sanvinpaul/adas-ecu-edgeai-sensor-fusion/can-intrusion-detection/README.md

# CAN Intrusion Detection (WiFi infotainment attack surface + autoencoder IDS)

Adds an AI-based intrusion-detection layer and a realistic attack surface. The infotainment head unit
hosts a WiFi access point; an attacker who reaches it injects spoofed CAN frames,
and a separate gateway ECU running an **autoencoder** detects the anomaly and warns
the driver. This mirrors the 2015 Jeep Cherokee attack path (infotainment → CAN).

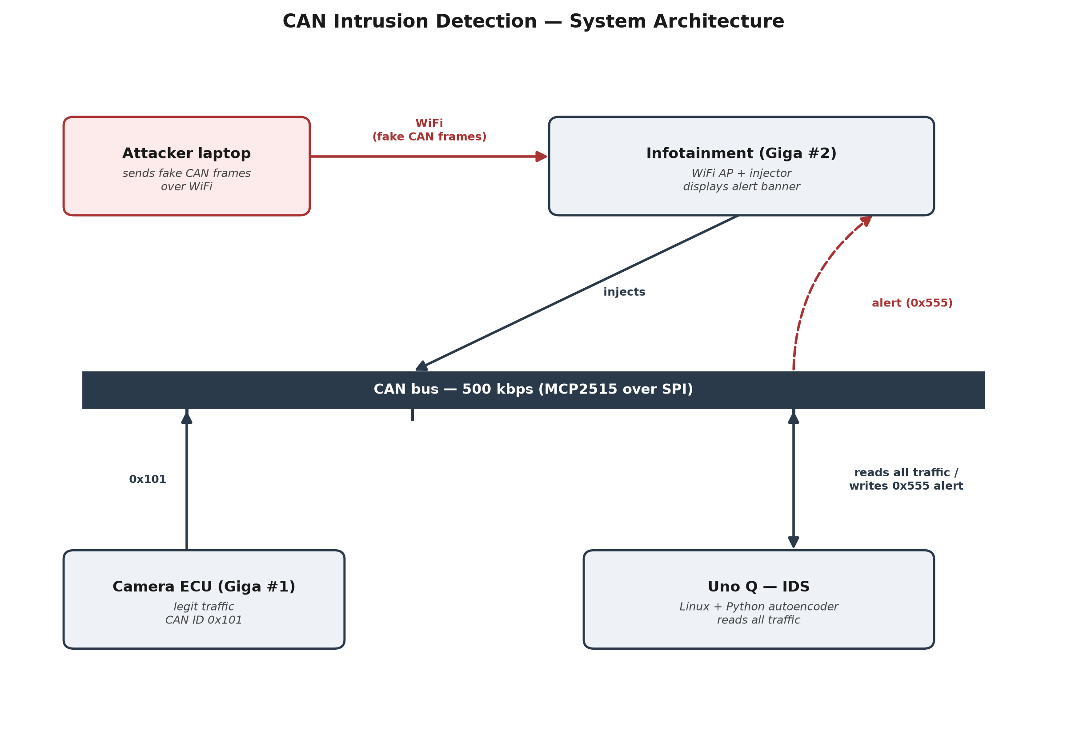
[picture p1: docs/architecture-can-intrusion-detection.png]
architecture


> Export the architecture diagram to `docs/architecture-can-intrusion-detection.png`.

## Nodes

| Node | Firmware / code | Role |
|---|---|---|
| Camera ECU (Giga #1) | `firmware/giga1_camera_ecu/` | Unchanged from the Sensor Fusion Baseline feature — legit `0x101` baseline traffic |
| Infotainment (Giga #2) | `firmware/giga2_infotainment/` | WiFi AP + web dashboard; injects `spoof/flood/replay/fuzz`; shows the alert |
| WiFi AP checkpoint | `firmware/phase1_wifi_ap_test/` | Standalone test to prove the AP before integration |
| IDS gateway (Uno Q) | `firmware/unoq_can_forwarder/` + `ids/` | MCU streams frames to Linux; Python autoencoder scores them and broadcasts `0x555` |

## Why an autoencoder

Real attacks are open-ended and unlabeled. The autoencoder trains only on *normal*
traffic and flags anything that reconstructs poorly — so it generalises to attacks
it never saw. Detection leans on timing/frequency features (a spoofed `0x101`
doubles its rate and breaks its regular period).

## Host-side pipeline (`ids/`)

| Script | Purpose |
|---|---|
| `features.py` | Shared window feature extraction (identical in train + detect) |
| `capture.py` | Log CAN frames to labeled CSV |
| `train.py` | Train the autoencoder on normal data, pick a threshold |
| `detect.py` | Live inference; sends `ALERT,type,score` to the MCU on anomaly |

## Run it

```bash
# 1) flash all four firmware sketches (start with phase1_wifi_ap_test on Giga #2)
# 2) capture data on the Uno Q Linux side
cd ids && pip install -r requirements.txt
python capture.py --port /dev/ttyACM0 --label normal --out ../data/normal.csv
python capture.py --port /dev/ttyACM0 --label spoof  --out ../data/attack_spoof.csv
# 3) train
python train.py --normal ../data/normal.csv --attacks ../data/attack_spoof.csv
# 4) detect live
python detect.py --port /dev/ttyACM0
```

Connect a laptop to the `CarInfotainment` AP, trigger an injection from the
dashboard, and watch the alert reach the head unit's OLED and web page.

## Results

### v1 -- Initial training run

First real hardware capture: ~16 minutes of normal traffic (78 training
windows, WINDOW_SIZE=50 frames), plus one capture per attack type triggered
by clicking each dashboard injection link 5-10 times during a ~1 minute
window.

Threshold (99.5th pct of normal error): 1.46265

| Attack | Detection rate | Windows evaluated |
|---|---|---|
| Spoof  | 40.0% | 35 |
| Flood  | 100.0% | 7  |
| Replay | 100.0% | 8  |
| Fuzz | 100.0% | 8  |

**Flood, replay, and fuzz were detected perfectly.** Each produces a large,
unambiguous statistical shift -- a 200-frame burst, a duplicated timing
pattern, or entirely foreign CAN IDs -- all of which stand out sharply against
the learned "normal" baseline.

**Spoof detection was weak (40%), and that's the attack that matters most**
for this project's threat model -- it's the one modeled directly on the real
Jeep Cherokee case study (https://www.wired.com/2015/07/hackers-remotely-kill-jeep-highway/)
that motivates the whole design (an attacker impersonating a legitimate ECU).
The likely cause: injectSpoof() sends exactly **one** extra 0x101 frame
per click, versus 200 frames per flood click or continuous foreign traffic
for fuzz. With only 5-10 clicks spread across a full minute of otherwise
normal traffic, the perturbation to the 0x101 timing/frequency features was
genuinely subtle -- arguably realistic for how a careful real-world attacker
would behave, but hard for a model trained on only ~78 normal windows to
separate confidently from natural jitter.

This is a legitimate, documented finding in CAN IDS research more broadly:
volume-based attacks (flooding, fuzzing) are inherently easier to detect via
timing/frequency features than stealthy identity-spoofing attacks that mimic
legitimate traffic patterns closely.

**Next step:** recapture spoof traffic with much more aggressive injection
(rapid repeated clicks rather than spread out) to give the model a stronger
signal, then retrain. Results below once that's complete.

### v2 -- Investigating the spoof detection gap

The obvious first move -- recapture spoof traffic with much more aggressive
injection (rapid clicking instead of spread out) -- didn't move the needle:

```
Threshold (99.5th pct of normal error): 1.22123
  attack_spoof.csv:  38.6% (44 windows)   [v1 was 40.0%, 35 windows]
  attack_flood.csv:  100.0% (7 windows)
  attack_replay.csv: 100.0% (8 windows)
  attack_fuzz.csv:   100.0% (8 windows)
```

Despite capturing far more total traffic (2222 frames vs. ~1750 in v1), the
spoof detection rate was flat. **That result rejected the v1 hypothesis** --
signal volume wasn't the problem.

**Root cause, found by inspecting the capture directly:** capture.py labels
an entire file "spoof", but injectSpoof() only fires on a dashboard click --
the camera ECU keeps transmitting its own legitimate 0x101 the whole
capture regardless. Checking attack_spoof.csv directly (d1==255 is
injectSpoof()'s signature payload byte): only **99 of 1140** 0x101 frames
(8.7%) were actually injected. Nearly all of the file's 44 windows almost
certainly contained **zero** injected frames -- meaning the "detection rate"
metric was largely measuring the model's behavior on windows that were
mislabeled attacks but were actually just normal traffic.

A diagnostic script (ids/diagnose_spoof_labels.py) was added to recompute
ground truth per window (does this specific window contain a frame matching
the injection signature?) instead of trusting the file-level label:

```
Total windows: 44
  Windows with >=1 injected frame (true attack): 7
  Windows with 0 injected frames (mislabeled "spoof", actually normal): 37

Corrected detection rate (recall on TRUE attack windows only): 7/7 = 100.0%
False alarm rate on windows mislabeled "spoof" but actually clean: 10/37 = 27.0%
```

**The model detects spoofing perfectly (7/7) once ground truth is measured
correctly at the window level.** The original 38-40% figures were an
artifact of file-level labeling granularity, not a model weakness.

The 27% false-alarm rate on the mislabeled-clean windows was checked
separately against the true baseline capture, to rule out general threshold
miscalibration:

```
Normal windows: 78, flagged as anomaly: 2 (2.6%)
```

2.6% is close to the nominal ~0.5% expected from a threshold set at the
99.5th percentile of a small (~15-window) validation split -- reasonable given
the dataset size. The 27% figure, roughly 10x higher, is specific to
conditions *during the spoof-testing session itself* (active clicking,
WiFi/HTTP load from the dashboard requests, possible movement near the
ultrasonic sensor) rather than a broken threshold -- the model stays quiet on
genuinely calm traffic but is more sensitive to session-level environmental
drift than pure attack presence.

| Metric | v1 (naive, file-level label) | v2 (corrected, per-window ground truth) |
|---|---|---|
| Spoof detection | 40.0% | **100.0%** (7/7 true-attack windows) |
| False alarms on "clean" windows | n/a | 27.0% (10/37, session-specific) |
| False alarms on true baseline | n/a | 2.6% (2/78, near-nominal) |

### Key takeaway

The real lesson from this project wasn't "tune the model until spoof detection
improves" -- it was that **the evaluation methodology itself had a labeling
granularity mismatch** between file-level attack labels and per-window ground
truth. That's arguably a more valuable finding than a clean 100% number would
have been on its own.

### v3 -- Firmware fix + fresh baseline (root cause resolved)

Live detection (`detect.py`) surfaced a third issue not visible in offline
training/evaluation at all: near-continuous low-grade false alarms whenever a
WiFi client was connected to the dashboard, and silence when it wasn't. Two
causes were found and fixed in sequence:

1. **32-bit `micros()` rollover** -- after an extended `detect.py` session,
   Arduino's 32-bit microsecond counter wrapped, and sorting timestamps by
   raw value (the original implementation) broke across that boundary,
   producing single gaps of ~4.29 million ms and reconstruction errors in the
   tens of thousands. Fixed in `features.py` by unwrapping timestamps in
   natural arrival order instead of sorting by value.
2. **WiFi-serving jitter** -- the dashboard's auto-refresh (originally every
   2s) triggered `handleClient()`, which made ~15 separate blocking network
   writes to build the HTML response. That blocking time delayed the next
   scheduled `0x102` CAN send, disrupting timing the model had only ever seen
   as precise. This was a genuine train/serve mismatch: `normal.csv` had been
   captured with the dashboard idle, not reflecting real operating conditions
   (the dashboard has to be open to test attacks).

The second issue was deliberately fixed at the **firmware level** rather than
by retraining the model to tolerate the jitter. The disrupted features
(`iat_mean`/`iat_std` for `0x101` and `0x102`) are the exact features
spoof/replay attacks manifest through -- broadening "normal" to include
timing jitter risked desensitizing the model to the real attacks this
feature exists to catch. `sendDashboard()` was consolidated into a single
buffered write and the refresh interval lengthened to 5s, both reducing how
much and how often serving disrupts CAN timing.

A fresh `normal.csv` was then captured **with the dashboard open** (matching
real operating conditions) and the ultrasonic sensor allowed to vary
naturally, rather than sitting artificially static -- a model trained on zero
payload variation would flag legitimate real-world movement as anomalous.

```
Threshold (99.5th pct of normal error): 22.57849   [v2 was 1.22123]
  attack_spoof.csv:  15.9% (44 windows)   [naive, file-level label]
  attack_flood.csv:  100.0% (7 windows)
  attack_replay.csv: 100.0% (8 windows)
  attack_fuzz.csv:   100.0% (8 windows)
```

Corrected per-window ground truth (diagnose_spoof_labels.py) against the new
model:

```
Corrected detection rate (recall on TRUE attack windows only): 7/7 = 100.0%
False alarm rate on windows mislabeled "spoof" but actually clean: 0/37 = 0.0%
```

| Metric | v2 | v3 |
|---|----|----|
| Threshold | 1.22 | 22.58 |
| Spoof detection (true-attack windows) | 100.0% (7/7) | **100.0% (7/7)** |
| False alarms on mislabeled-clean windows | 27.0% (10/37) | **0.0% (0/37)** |
| Flood / Replay / Fuzz | 100% | 100% |

**Fixing the root cause rather than retraining around it preserved full
attack sensitivity while eliminating false alarms from normal operation.**
Had the jitter simply been tolerated via retraining alone (without knowing
whether that traded away sensitivity), there would have been no way to
distinguish "the model got more robust" from "the model got less alert" --
the corrected per-window metric is what makes that distinction possible.

## On-device deployment

Two parallel efforts to run this model on real edge/automotive hardware,
rather than only a development laptop.

### Qualcomm AI Hub — NPU benchmarking (✅ complete, verified)

The trained autoencoder (`model.keras`) was converted to ONNX
(`convert_to_onnx.py`) — Qualcomm AI Hub's `submit_compile_job()` only
accepts PyTorch or ONNX models, not native Keras. The conversion was
numerically verified before use: the ONNX model's output matched the
original Keras model exactly (max absolute difference `0.0`) on a test
input.

The model was then compiled and profiled on a real, hosted **SA8775P ADP**
(Qualcomm Snapdragon Ride automotive SoC) via `submit_to_aihub.py`:

```
Device:            SA8775P ADP (Qualcomm® SA8775P), Android 14
Input:              float32[1, 10]
Status:             SUCCESS (compile + profile)
Inference time:     0.2 ms (minimum / median)
Peak memory:        0 - 18 MB
NPU placement:      4/4 layers (100%) -- "Model is fully delegated=true"
                     in the raw runtime log, zero CPU fallback
Compute cycles:     3,736 total across all 4 layers (~2 us of raw NPU math)
Delegate overhead:  ~413 us (QNN/HTP pipeline dispatch)
```

**Comparison to development hardware:** 0.2 ms on the SA8775P's NPU vs.
14.68 ms (median) on a laptop CPU — roughly a **73x** speedup on dedicated
automotive NPU silicon.

**Notable finding:** the actual NPU computation for this model is only ~2 us
(3,736 compute cycles); the ~413 us `TfLiteQnnDelegate` dispatch step
dominates total latency. For a model this small, NPU invocation overhead is
the real bottleneck, not compute -- meaning a meaningfully larger/more
complex model could likely run with a similar latency profile, since the
fixed dispatch cost, not FLOPs, is what's being paid here.

**Known discrepancy, documented rather than hidden:** the AI Hub dashboard
labels the target device "SA8775P ADP," but the raw runtime log's own
Android system properties self-report differently
(`ro.soc.model = SA8255P`, `Detected Qualcomm SOC=SA8255`). Both chips are
part of the same Snapdragon Ride/Cockpit family; this is very plausibly a
shared reference/development platform used across closely related silicon
variants, but that explanation isn't independently confirmed.

### App Lab Custom Brick — on-device Uno Q deployment (🚧 in progress)

Separately, the same detection logic (`ids_core.py`) was adapted into an
Arduino App Lab Custom Brick, intended to run the full IDS natively on the
Uno Q's own Linux side -- no laptop, no external serial tether -- using
`Bridge.call()`/`Bridge.provide()` RPC instead of raw serial parsing (see
`onboard-brick/`).

**Status so far:**
- Sketch compiles and flashes successfully (10% program storage, 12% dynamic
  memory used).
- The Brick's Docker container builds successfully (TensorFlow and all
  dependencies install cleanly).
- Both containers (`can_ids_scorer` and `main`) start.
- **Runtime errors occur during App Lab's "Run"** that haven't been
  root-caused yet -- the Brick does not yet reliably reach a confirmed
  working state end-to-end. Two known open uncertainties going in: whether
  `Bridge.call()`'s multi-argument form (used to push each CAN frame's ID,
  length, and 8 data bytes) is actually supported the way it's written, or
  needs packing into a single argument instead; and whether the shared
  modules' import path within the Brick's sandboxed environment is correct.

This is left as an open item rather than a completed feature -- unlike the
AI Hub results above, this has not yet been verified working on hardware.

### Roadmap

- Capture ground truth at the frame level (e.g. have the firmware stamp
  injected frames, rather than inferring via the d1==255 heuristic) so
  future evaluation doesn't need a separate diagnostic pass.
- Capture a larger normal baseline (current: 78 windows / ~16 minutes) to
  tighten threshold calibration.
- Compare against an Isolation Forest baseline.
