sanvinpaul/adas-ecu-edgeai-sensor-fusion/(commit log)

2026-07-13 feat(sensor-fusion-baseline): camera ECU sends brightness/visual-cue on 0x101
2026-07-13 feat(sensor-fusion-baseline): ultrasonic node broadcasts 0x102 and drives OLED
2026-07-13 feat(sensor-fusion-baseline): Uno Q aggregator prints JSON telemetry over serial
2026-07-13 docs(sensor-fusion-baseline): baseline sensor-network overview and run steps
2026-07-13 chore(can-intrusion-detection): carry over camera ECU as legit baseline traffic
2026-07-14 fix(sensor-fusion-baseline): slow Board2 ultrasonic broadcast to 500ms to relieve Board1 CAN buffer
    The 100ms transmit rate on Board2 was overloading the MCP2515's transmit
    buffer on Board1's side, causing errors. Slowing to 500ms brought bus
    traffic within comfortable limits and the errors disappeared completely.
    [giga2_sensor_display.ino]
2026-07-14 fix(can-intrusion-detection): drain unread CAN RX buffers on camera ECU
    The camera ECU only transmits but never read incoming CAN frames,
    letting the MCP2515's RX buffer fill up and trip CTRLERROR. Drain
    unread messages each loop and log the raw EFLG value on recovery for
    diagnosis.
    [giga1_camera_ecu.ino]
2026-07-14 fix(can-intrusion-detection): slow Board2 ultrasonic broadcast to 500ms to relieve Board1 CAN buffer
    Same MCP2515 TX buffer overload seen on the sensor-fusion baseline
    applies here too — 100ms was too fast for Board1 to keep up. Also
    leaves a commented-out SPI1.begin() as a note for a possible second
    SPI bus during future debugging.
    [giga2_infotainment.ino]
2026-07-14 chore(can-intrusion-detection): namespace WiFi AP test SSID to avoid collisions
    Renamed the phase1 test AP SSID to "CarInfotainment_san" to avoid
    colliding with other AP tests on the same network during bring-up.
    [phase1_wifi_ap_test.ino]
2026-07-14 fix(sensor-fusion-baseline): drain unread CAN RX buffers on camera ECU
    Same fix as can-intrusion-detection's camera ECU: this node only
    transmits but never read incoming CAN frames, letting the MCP2515's
    RX buffer fill up and trip CTRLERROR.
    [giga1_camera_ecu.ino]
2026-07-15 fix(can-intrusion-detection): drain all pending CAN frames per loop on infotainment node
    Same root cause as the earlier camera ECU fix, milder form: giga2_infotainment.ino
    used a single 'if (CAN.checkReceive()...)' instead of a loop, so only one message
    was drained from the MCP2515's receive buffers per loop() iteration. Since this
    node's loop is the busiest in the system (WiFi/HTTP handling, OLED refresh,
    ultrasonic), iteration rate can slow enough for incoming frames (0x101, and
    eventually 0x555) to queue up faster than they're drained, overflowing the
    2-deep hardware RX buffer and tripping CAN_CTRLERROR -- observed live during
    a 'normal' data capture run.
    Fix: changed the single if to a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
    [giga2_infotainment.ino]
2026-07-15 docs(can-intrusion-detection): document v1 training results and spoof detection gap
    First real hardware training run: autoencoder trained on 78 normal windows
    (~16 min capture), evaluated against all four attack types.
    Flood/replay/fuzz detected at 100%. Spoof detection came in at only 40% --
    notable because spoofing is the attack this project's threat model is built
    around (impersonating a legitimate ECU, per the Jeep Cherokee case study).
    Root-caused to injectSpoof() producing a much subtler signal (1 frame/click)
    than the other attacks (200 frames/click for flood, continuous foreign
    traffic for fuzz), combined with a fairly small normal-traffic training set.
    Documented as an honest v1 b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
2026-07-15 fix(can-intrusion-detection): skip malformed CAN frames instead of crashing capture.py
    Hit during aggressive spoof-attack recapture: rapid CAN traffic caused a
    serial line to arrive as valid JSON but missing the 'dlc' key (likely a
    dropped byte on the USB serial link under heavy load), crashing the whole
    capture with an unhandled KeyError and losing all progress.
    Fix: validate that 't', 'id', and 'dlc' are all present before writing a row;
    skip and count malformed frames instead of crashing. Final summary now
    reports how many frames were skipped.
    [capture.py]
2026-07-15 feat(can-intrusion-detection): add per-window ground-truth diagnostic for spoof labels
    train.py's reported detection rate treats every window in an attack CSV as an
    attack window, but capture.py only stamps a file-level label -- the camera
    ECU keeps transmitting legitimate 0x101 the whole capture, so most windows in
    attack_spoof.csv likely contain zero actually-injected frames. Confirmed on
    real data: only 99 of 1140 0x101 frames (8.7%) in a 2222-frame spoof capture
    were injected (d1==255 heuristic), meaning the naive 38.6% detection rate is
    measuring a confounded metric, not pure model performance.
    Adds diagnose_spoof_labels.py: recomputes per-window ground truth from the
    injectSpoof() pay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
2026-07-15 docs(can-intrusion-detection): document v2 spoof investigation and corrected results
    Recapturing spoof data more aggressively (v1->v2: ~1750->2222 frames) did not
    improve the naive detection rate (40.0% -> 38.6%), rejecting the v1 hypothesis
    that signal volume was the limiting factor.
    Root cause found by inspecting the capture directly: capture.py labels an
    entire file 'spoof', but the camera ECU keeps transmitting legitimate 0x101
    throughout the capture regardless of injection. Only 99/1140 (8.7%) of 0x101
    frames in the v2 capture were actually injected, so most windows labeled
    'spoof' contained zero injected frames -- the naive metric was measuring a
    mislabeled majority, not model perform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
2026-07-15 fix(can-intrusion-detection): skip malformed CAN frames in detect.py, same as capture.py
    Live detection was firing false ANOMALY alerts with no injection triggered,
    including wildly inflated reconstruction errors (up to ~70000 against a
    threshold of 1.22). Root cause: detect.py validated JSON syntax but not that
    required keys (t, id, dlc) were present, unlike capture.py which was already
    fixed for this. A single frame with a corrupted timestamp (dropped serial
    byte) produces an absurd feature value, and since the sliding window only
    advances 10 frames between scoring passes, one bad frame poisons ~5
    consecutive scoring cycles -- matching the observed bursts of extreme
    readings.
    Fix: same re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
    [detect.py]
2026-07-15 fix(can-intrusion-detection): handle micros() 32-bit rollover in feature extraction
    Live detect.py, run continuously for an extended session, started firing
    persistent false ANOMALY alerts (err in the hundreds, misclassified as
    'spoof') even with no injection triggered. Root cause: Arduino's micros() is
    a 32-bit unsigned counter that wraps to 0 every ~71.6 minutes. window_features()
    sorted timestamps by raw numeric value before computing inter-arrival gaps --
    across a rollover boundary this puts small post-wrap values before the large
    pre-wrap values they actually came after, producing a single ~4.29-million-ms
    gap that explodes iat_mean/iat_std and poisons every window it's part of.
    Verifi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
2026-07-15 fix(can-intrusion-detection): reduce WiFi-serving jitter on CAN timing
    detect.py showed near-continuous low-grade false alarms (err 1.2-6, spiking
    higher) that correlated exactly with a WiFi client being connected and the
    dashboard auto-refreshing, and went quiet with no client connected. Root
    cause: the dashboard's 2s auto-refresh triggers handleClient() roughly every
    2 seconds, which made ~15 separate client.println() network writes to build
    the HTML response -- real blocking time inside loop() that delayed the next
    scheduled 0x102 send, disrupting timing the model was trained on as precise.
    Chose to fix this at the firmware level rather than retrain the model to
    tolerate the jitter: the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
    [giga2_infotainment.ino]
2026-07-15 docs(can-intrusion-detection): document v3 firmware fix and root-cause resolution
    Live detect.py surfaced a third issue invisible to offline evaluation: near-
    continuous false alarms correlated exactly with WiFi client connection state.
    Traced to two causes and fixed in sequence: (1) 32-bit micros() rollover
    during extended sessions, fixed in features.py; (2) WiFi-serving jitter from
    the dashboard's 2s auto-refresh delaying scheduled 0x102 sends, fixed at the
    firmware level (consolidated sendDashboard() writes, lengthened refresh to
    5s) rather than by retraining the model to tolerate the jitter -- the
    disrupted features are the same ones spoof/replay attacks manifest through,
    so widening tol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
2026-07-15 feat(can-intrusion-detection): add per-feature diagnostic output to detect.py alerts
    Live detect.py started producing near-continuous errors in the thousands
    (threshold 22.58) with the OLED alert banner staying lit continuously --
    evidence of a sustained condition or feedback loop, but the aggregate err
    number alone didn't say which feature was actually driving it, after ruling
    out the previously-fixed causes (malformed frames, 0x555 self-feedback,
    micros() rollover, WiFi-serving jitter).
    Rather than guess at a fourth cause, added a diagnostic: whenever an alert
    fires, print the top-3 highest-residual features and the full raw feature
    vector, so the actual driving feature(s) can be inspecte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
    [detect.py]
2026-07-15 fix(can-intrusion-detection): floor scaler scale to prevent runaway z-scores on low-variance features
    Live detect.py produced errors in the thousands even though raw feature
    values were completely normal (iat_mean_0x101 ~468-510ms against a 500ms
    nominal interval, unremarkable jitter). Added per-feature diagnostics to
    detect.py to inspect this directly rather than guess further; the top
    contributor was consistently iat_mean_0x101/iat_std_0x101/count_0x101 with
    squared residuals in the tens of thousands.
    Root cause: back-of-envelope math from the observed residual implied a
    training std for iat_mean_0x101 of ~0.11ms -- near machine-precision
    consistency. Giga #1's camera loop doesn't touch W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
    [train.py]
2026-07-15 feat(can-intrusion-detection): print per-feature training statistics in train.py
    After the scaler-floor fix, live detect.py still fired continuously, now
    driven by iat_std_0x101 initially and increasingly mean_payload_delta and
    frames_per_sec as the session progressed. Rather than guess at another floor
    adjustment, print each feature's actual training mean/std/min/max so
    low-variance or near-static features (a single ~15min capture session may
    simply never have exercised some features' realistic range, e.g. if nothing
    moved near the ultrasonic sensor much) can be identified directly instead of
    inferred from live residuals alone.
    [train.py]
2026-07-15 fix(can-intrusion-detection): correct FUZZ threshold and split REPLAY from SPOOF in classify()
    classify() always returned SPOOF for both replay and fuzz attacks:
    - Replay was intentionally grouped with spoof (both disrupt 0x101 timing
    identically in feature space), but this made the demo unable to
    distinguish the two despite the firmware/backend fully supporting
    distinct attack types.
    - Fuzz's threshold (n_unique_ids >= 6) never realistically triggered:
    injectFuzz() sends exactly one random-ID frame per click, bumping
    n_unique_ids from 2 to 3, never close to 6. Confirmed directly from live
    data (n_unique_ids=3, id_entropy up to 1.55 across many real fuzz clicks,
    never approachi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
    [detect.py]
2026-07-16 feat(can-intrusion-detection): add --dry-run flag to isolate serial-write disruption
    Two separate normal-traffic capture sessions (102 and 210 windows, ~15min and
    ~25-30min, the second with deliberately varied ultrasonic movement) both
    showed iat_std_0x101 capped under ~8ms and iat_mean_0x101 with a training std
    of ~0.18ms across both -- reproducibly tight, genuine hardware behavior, not
    a sampling gap. Yet live detect.py sessions consistently show iat_std_0x101
    in the 83-148ms range. More/longer capturing does not close this gap because
    it likely isn't a data-coverage problem.
    The one thing every capture.py session has in common (and never exercises)
    is that it never writes to the serial p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
    [detect.py]
2026-07-16 fix(can-intrusion-detection): avoid heap allocation in Uno Q serial command parsing
    Confirmed via detect.py --dry-run: with the ALERT write to the Uno Q disabled
    entirely, iat_std_0x101 stayed within its trained range (3.04-3.39ms against
    a training mean of 3.82ms) across two anomalies, versus 83-148ms in every
    prior live session where writes were enabled. This conclusively identifies
    the alert write, and the Uno Q's handling of it, as the disruption source.
    handleSerialCommand() used an Arduino String (cmd += c per character), which
    reallocates on the heap. After hours of continuous uptime with repeated
    alert processing throughout this session, heap fragmentation could easily
    cause an unpr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
    [unoq_can_forwarder.ino]
2026-07-16 fix(can-intrusion-detection): ground classify() SPOOF/REPLAY threshold in real data
    Discovered while reviewing --dry-run output: two benign WiFi-churn anomalies
    (new client connecting, reconnection after phone unlock) were both labeled
    REPLAY, despite their actual top contributors being mean_payload_delta and
    frames_per_sec -- nothing to do with 0x101 at all. Root cause: the SPOOF/
    REPLAY branch triggered on 'count_0x101 > 20', but normal traffic always has
    count_0x101 around 24-26, making this condition essentially always true
    regardless of actual cause. The secondary 'iat_std_0x101 > iat_mean_0x101'
    check was the opposite problem -- unreachable in practice, since iat_mean is
    consistently ~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
    [detect.py]
2026-07-16 fix(can-intrusion-detection): redirect after injection instead of serving content at /inject/* URL
    Root-caused a 'spontaneous' spoof burst with zero clicking: the browser was
    left sitting on /inject/spoof from a prior test (clicking a link navigates
    the browser TO that URL, and the server serves the dashboard back at that
    same address). Refreshing that page re-sent the exact same GET request,
    silently re-triggering the injection with no click at all -- indistinguishable
    from a real click at the server, and correctly detected as a genuine (if
    accidental) spoof by the IDS. Not a bug in the ML pipeline, CAN handling, or
    detection logic at all -- purely a web-routing design issue.
    Fix: standard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
    [giga2_infotainment.ino]
2026-07-16 fix(can-intrusion-detection): correctly distinguish FLOOD from FUZZ in classify()
    Clicking Flood was being classified as FUZZ. Root cause: injectFlood() sends
    200 frames of 0x000 in a fast burst that usually completes in well under a
    second, but the 50-frame scoring window covers ~12.5s of normal-rate traffic
    -- so most scored windows only caught a partial slice of the burst mixed
    with regular 0x101/0x102 traffic, never approaching the frames_per_sec > 2000
    threshold. Once 0x000 appeared at all, n_unique_ids became 3, which the FUZZ
    branch (checked next) caught first, since both flood and fuzz share the
    trait of introducing an unexpected ID.
    Fix: count frames in the raw window that aren't 0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
    [detect.py]
2026-07-16 fix(can-intrusion-detection): use flood's fixed 0x000 ID signature instead of frame count
    Previous fix (other_count > 10) was based on a flawed assumption: real
    testing showed flood clicks were still classifying as FUZZ, and the raw
    feature vectors explain why -- count_0x101 + count_0x102 summed to 49-50 out
    of 50 in nearly every window, meaning only 1-2 flood frames actually survived
    to reach Python, nowhere near the >10 threshold. injectFlood()'s 200-frame
    burst is almost entirely dropped in the pipeline: CAN frames arrive roughly
    every ~260us at 500kbps, but printing one JSON line over serial takes several
    milliseconds, so the Uno Q can't keep up and most flood frames never get
    forwarded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
    [detect.py]
2026-07-16 fix(can-intrusion-detection): add UNKNOWN classification instead of defaulting to SPOOF
    Rapid ultrasonic sensor variation (fast hand-waving in front of the sensor,
    no attack triggered) was being labeled SPOOF, despite iat_std_0x101,
    count_0x101, n_unique_ids, and frames_per_sec all sitting well within normal
    ranges -- only mean_payload_delta was elevated, from real payload variation
    more extreme than anything in training. Nothing about this matched any
    attack's actual signature; it fell through every specific branch to the
    unconditional 'return SPOOF' fallback at the bottom of classify(), which
    mislabeled any unrecognized anomaly by default.
    The autoencoder's detection was arguably correct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
    [detect.py, giga2_infotainment.ino]
2026-07-16 refactor(can-intrusion-detection): extract IDSScorer into ids_core.py for on-device reuse
    Phase A of moving IDS detection onto the Uno Q itself via an App Lab Custom
    Brick (currently laptop-tethered via USB serial). Extracted model loading,
    window scoring, and classify() out of detect.py into a new ids_core.py with
    zero CLI/argparse/serial dependencies -- an IDSScorer class exposing
    score_window() and top_contributors(). Both the laptop CLI (detect.py,
    unchanged behavior) and the planned on-device Custom Brick will import from
    this single shared module, so detection logic can't silently drift between
    the two deployment modes.
    detect.py is now a thin CLI wrapper: reads serial, drains/validat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
    [detect.py, ids_core.py]
2026-07-16 feat(can-intrusion-detection): add on-device Custom Brick using confirmed Bridge RPC
    Complete onboard-brick/ tree: Custom Brick (__init__.py using Bridge.provide/
    Bridge.call), shared features.py/ids_core.py, a Dockerfile + brick_compose.yaml
    for the Python+Container dependency setup, and sketch.ino using
    Arduino_RouterBridge instead of raw Serial parsing.
    Bridge RPC pattern confirmed from Arduino's own official "What is an App?"
    documentation (Bridge.provide/Bridge.call, Arduino_RouterBridge.h) -- not
    guessed. Callback mechanics (window management, 0x555 exclusion, alert firing)
    verified with a mocked arduino.app_utils module. classify()/IDSScorer logic
    unchanged from the hardware-validate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
2026-07-18 feat(can-intrusion-detection): add benchmark script for latency/footprint metrics
    The README's results section had detection rate and false-positive rate
    (both verified through real testing) but no inference latency or model
    footprint numbers -- neither was ever actually measured. Rather than publish
    placeholder figures, added benchmark.py to measure both honestly: per-file
    and total model footprint (model.keras + scaler.joblib + threshold.json),
    model load time (one-time cost, reported separately from per-inference
    latency), and inference latency over 100 runs (mean/median/p95/min/max) on
    whatever target it's run on.
2026-07-22 feat(can-intrusion-detection): add Qualcomm AI Hub compile/profile job submission script
    Submits model.onnx to a hosted device (targeting the SA8775P/Lemans
    Snapdragon Ride SoC) for compilation and profiling, using the confirmed
    qai_hub API pattern (submit_compile_job -> get_target_model ->
    submit_profile_job) from Qualcomm's own documentation.
    Requires: DEVICE_NAME placeholder replaced with the exact device string
    found via hub.get_devices() search (don't guess it -- device names must
    match exactly).
    Not independently verified: this needs a live AI Hub account/API token and
    network access to Qualcomm's servers to actually run, neither available in
    this sandbox. The job-URL format printed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
    [submit_to_aihub.py]
2026-07-22 fix(can-intrusion-detection): correct AI Hub job URL to use workbench subdomain
    The URLs this script printed at the end (aihub.qualcomm.com/jobs/...) were
    an unconfirmed guess, flagged as such when the script was written. Real run
    confirmed both compile and profile jobs succeeded on SA8775P ADP hardware,
    but the printed URLs 404'd -- the actual qai_hub client prints
    workbench.aihub.qualcomm.com/jobs/<id>/ (confirmed directly from the live
    job-submission output), a different subdomain than guessed. Fixed to match.
    [submit_to_aihub.py]
2026-07-22 docs(can-intrusion-detection): document Qualcomm AI Hub NPU results and honest App Lab status
    Documents two parallel on-device efforts: Qualcomm AI Hub NPU benchmarking
    (complete, verified -- 0.2ms median inference on real SA8775P ADP hardware,
    100% NPU placement, ~73x speedup over the 14.68ms laptop baseline, plus a
    notable finding that QNN delegate dispatch overhead dominates over actual
    compute for a model this small) and the App Lab Custom Brick on-device
    deployment, documented honestly as still in-progress with unresolved Run
    errors -- not claimed as working, since it hasn't been verified as such.
